MarcelMG/STM32F373_Dev_Board/README.md

# STM32F373_Dev_Board
a development board for the STM32F373 microcontroller with USB and separate analog power supply
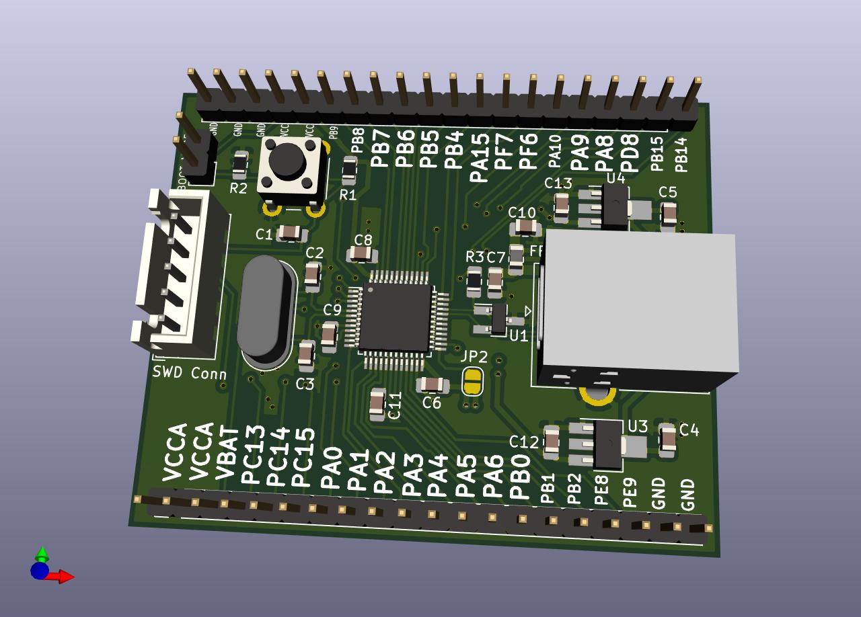
[picture p1: rendering3D.jpg]
3drendering
