MarcelMG/STM32F373_Dev_Board/BOM_parts_RSComponents.xlsx

Best.-Nr. | Bezeichnung | Stückpreis | Anzahl | Mindestbestellmenge | Preis
698-4064 | 27pF 0805 | 0.06 | 10 | 5 | 0.6
814-9412 | 8MHz Quarz | 0.172 | 10 | 10 | 1.72
751-3033 | 3.3V LDO Regler | 0.108 | 25 | 25 | 2.7
298-9309 (https://de.rs-online.com/web/p/keramik-vielschichtkondensatoren/2989309/) | 10nF 0805 | 0.004 | 25 | 25 | 0.1
264-4450 | 1µF Kondensator | 0.043 | 25 | 25 | 1.075
674-1328 | USB Buchse Typ B weibl. | 0.896 | 5 | 5 | 4.48
740-8990 (https://de.rs-online.com/web/p/smd-widerstande/7408990/) | 1.5k 0805 | 0.012 | 50 | 50 | 0.6
709-9054 | USB ESD Schutz | 0.496 | 5 | 5 | 2.48
724-1501 | Ferritperle | 0.024 | 25 | 25 | 0.6
464-6688 (https://de.rs-online.com/web/p/keramik-vielschichtkondensatoren/4646688/) | 100nF 0805 | 0.011 | 50 | 50 | 0.55
152-6094 (https://de.rs-online.com/web/p/keramik-vielschichtkondensatoren/1526094/) | 4.7µF 0805 | 0.205 | 10 | 10 | 2.05
794-4055 | Taster | 0.082 | 5 | 5 | 0.41
674-2340 | 20pin 2.54mm Stiftleiste | 0.416 | 5 | 5 | 2.08
795-9167 | Mikrocontroller STM32F373 | 5.28 | 3 | 1 | 15.84
820-1560 | JST 5pin Buchse | 0.43 | 5 | 5 | 2.15
820-1541 | Kabel mit JST Kontakt | 0.68 | 10 | 10 | 6.8
820-1627 | Stecker Gehäuse JST XH | 0.108 | 5 | 5 | 0.54
788-3972 | 10k 0805 | 0.011 | 50 | 50 | 0.55
674-2400 (https://de.rs-online.com/web/p/jumper-und-steckbrucken/6742400/) | Jumper | 0.067 | 10 | 10 | 0.67
