MarcelMG/STM32F373_Dev_Board/schematic.pdf

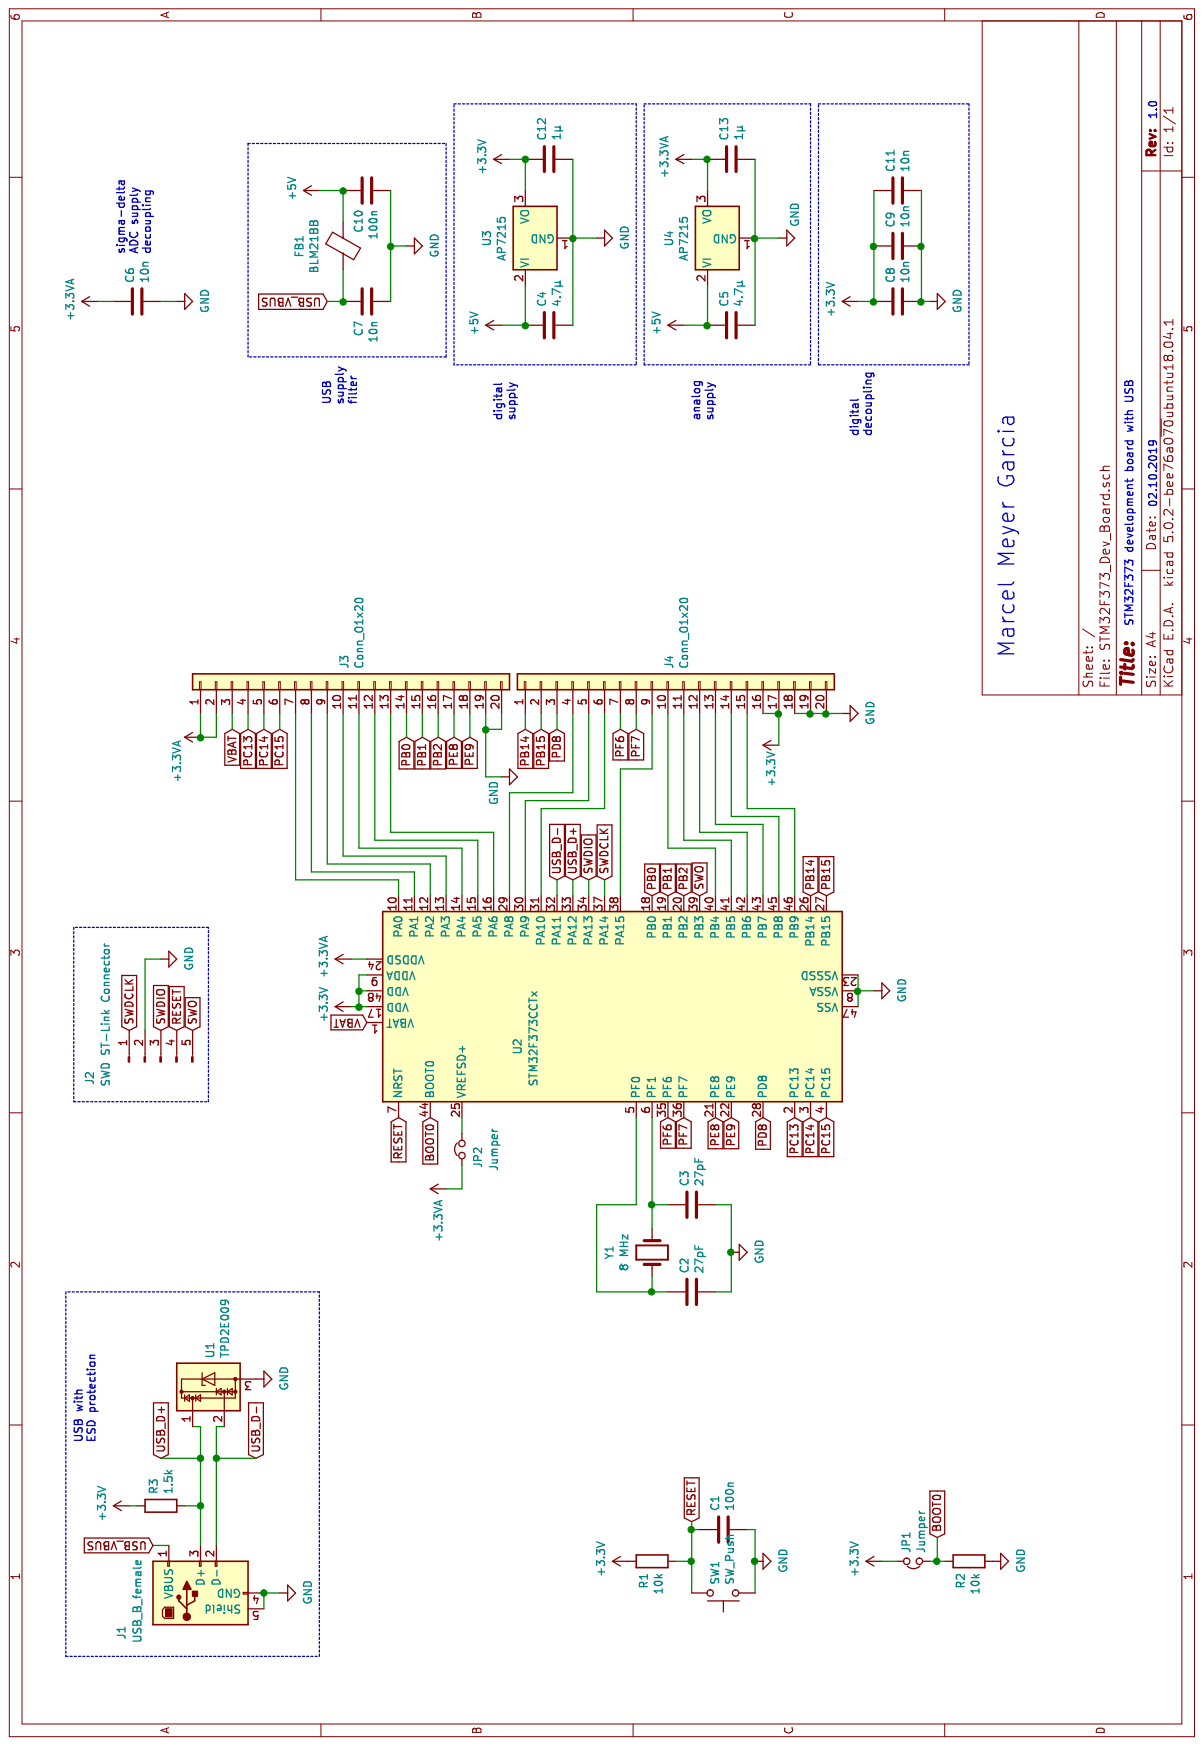
[picture p2: page 1]
