MarcelMG/STM32F373_Dev_Board/STM32F373_Dev_Board.kicad_pcb

## KiCad design STM32F373_Dev_Board.kicad_pcb (2019-10-04)

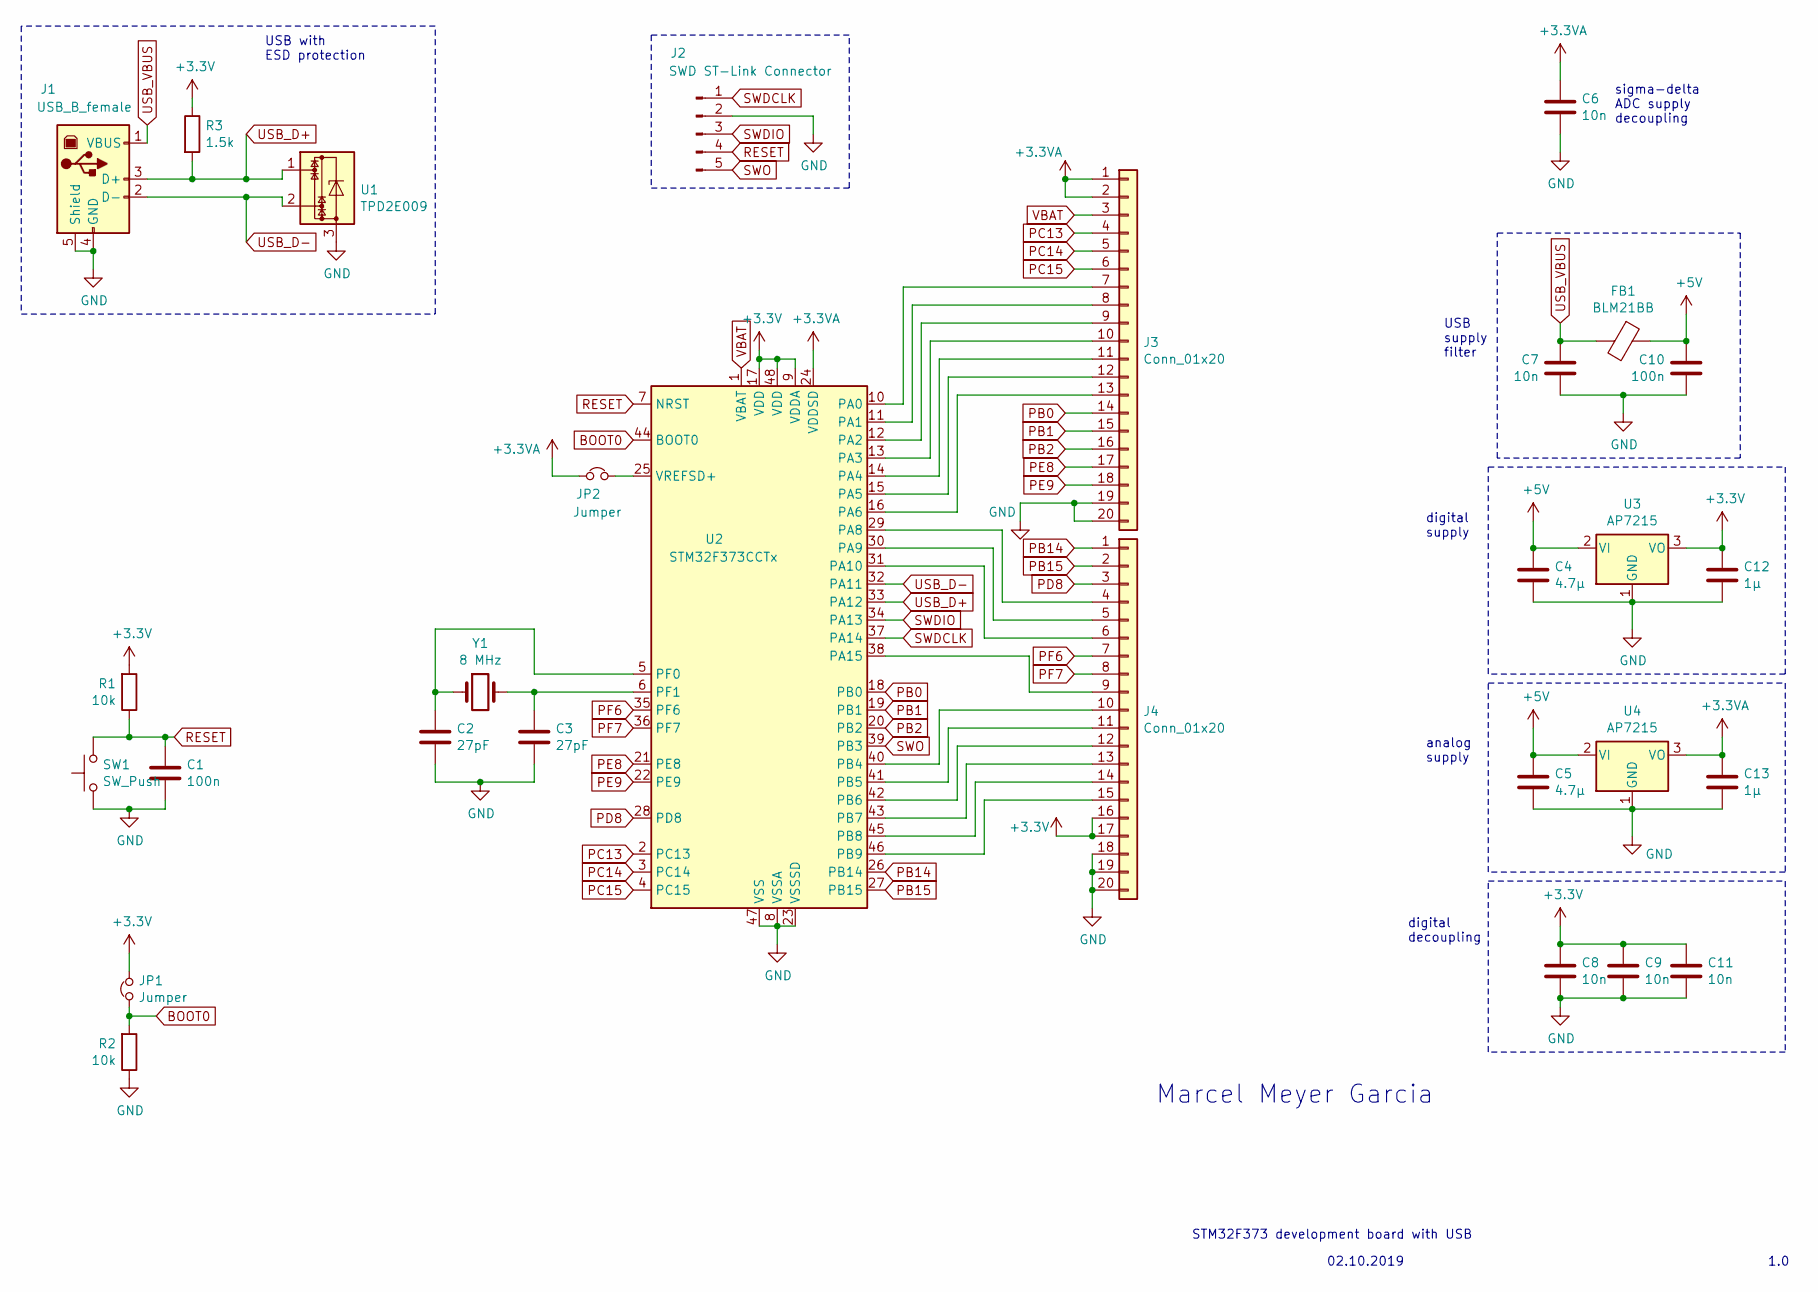
[picture p3: schematic STM32F373_Dev_Board.sch]

Parts:
C1, C10: 100n; C_0805_2012Metric_Pad1.15x1.40mm_HandSolder
C2, C3: 27pF; C_0805_2012Metric_Pad1.15x1.40mm_HandSolder
C4, C5: 4.7µ; C_0805_2012Metric_Pad1.15x1.40mm_HandSolder
C6, C7, C8, C9, C11: 10n; C_0805_2012Metric_Pad1.15x1.40mm_HandSolder
C12, C13: 1µ; C_0805_2012Metric_Pad1.15x1.40mm_HandSolder
FB1: BLM21BB; L_0805_2012Metric_Pad1.15x1.40mm_HandSolder
J1: USB_B_female; USB_B_OST_USB-B1HSxx_Horizontal
J2: SWD ST-Link Connector; JST_XH_B05B-XH-A_1x05_P2.50mm_Vertical
J3, J4: Conn_01x20; PinHeader_1x20_P2.54mm_Vertical
JP1: Jumper; PinHeader_1x02_P2.54mm_Vertical
JP2: Jumper; SolderJumper-2_P1.3mm_Open_RoundedPad1.0x1.5mm
R1, R2: 10k; R_0805_2012Metric_Pad1.15x1.40mm_HandSolder
R3: 1.5k; R_0805_2012Metric_Pad1.15x1.40mm_HandSolder
SW1: SW_Push; SW_PUSH_6mm_H5mm
U1: TPD2E009; SOT-23_Handsoldering
U2: STM32F373CCTx; LQFP-48_7x7mm_P0.5mm
U3, U4: AP7215; SOT-89-3_Handsoldering
Y1: 8 MHz; Crystal_HC49-U_Vertical

Connections:
+3.3VA: C6.1, C13.1, J3.1, J3.2, JP2.2, U2.24 (VDDSD), U4.3 (VO)
+3V3: C8.1, C9.1, C11.1, C12.1, J4.16, J4.17, JP1.1, R1.2, R3.1, U2.9 (VDDA), U2.17 (VDD), U2.48 (VDD), U3.3 (VO)
+5V: C4.1, C5.1, C10.2, FB1.1, U3.2 (VI), U4.2 (VI)
BOOT0: JP1.2, R2.2, U2.44 (BOOT0)
GND: C1.1, C2.2, C3.2, C4.2, C5.2, C6.2, C7.1, C8.2, C9.2, C10.1, C11.2, C12.2, C13.2, J1.4 (GND), J1.5 (Shield), J2.2, J3.19, J3.20, J4.18, J4.19, J4.20, R2.1, SW1.1, U1.3, U2.8 (VSSA), U2.23 (VSSSD), U2.47 (VSS), U3.1 (GND), U4.1 (GND); also elsewhere on the board
unnamed: C2.1, U2.5 (PF0), Y1.1
unnamed: C3.1, U2.6 (PF1), Y1.2
unnamed: J3.7, U2.10 (PA0)
unnamed: J3.8, U2.11 (PA1)
unnamed: J3.9, U2.12 (PA2)
unnamed: J3.10, U2.13 (PA3)
unnamed: J3.11, U2.14 (PA4)
unnamed: J3.12, U2.15 (PA5)
unnamed: J3.13, U2.16 (PA6)
unnamed: J4.4, U2.29 (PA8)
unnamed: J4.5, U2.30 (PA9)
unnamed: J4.6, U2.31 (PA10)
unnamed: J4.9, U2.38 (PA15)
unnamed: J4.10, U2.40 (PB4)
unnamed: J4.11, U2.41 (PB5)
unnamed: J4.12, U2.42 (PB6)
unnamed: J4.13, U2.43 (PB7)
unnamed: J4.14, U2.45 (PB8)
unnamed: J4.15, U2.46 (PB9)
unnamed: JP2.1, U2.25 (VREFSD+)
PB0: J3.14, U2.18 (PB0)
PB1: J3.15, U2.19 (PB1)
PB2: J3.16, U2.20 (PB2)
PB14: J4.1, U2.26 (PB14)
PB15: J4.2, U2.27 (PB15)
PC13: J3.4, U2.2 (PC13)
PC14: J3.5, U2.3 (PC14)
PC15: J3.6, U2.4 (PC15)
PD8: J4.3, U2.28 (PD8)
PE8: J3.17, U2.21 (PE8)
PE9: J3.18, U2.22 (PE9)
PF6: J4.7, U2.35 (PF6)
PF7: J4.8, U2.36 (PF7)
RESET: C1.2, J2.4, R1.1, SW1.2, U2.7 (NRST); also elsewhere on the board
SWDCLK: J2.1, U2.37 (PA14); also elsewhere on the board
SWDIO: J2.3, U2.34 (PA13); also elsewhere on the board
SWO: J2.5, U2.39 (PB3); also elsewhere on the board
USB_D+: J1.3 (D+), R3.2, U1.1, U2.33 (PA12)
USB_D-: J1.2 (D-), U1.2, U2.32 (PA11)
USB_VBUS: C7.2, FB1.2, J1.1 (VBUS)
VBAT: J3.3, U2.1 (VBAT)

Notes on the sheet:
digital supply
USB supply filter
analog supply
digital decoupling
sigma-delta ADC supply decoupling
USB with ESD protection
STM32F373 development board with USB
02.10.2019
1.0
Marcel Meyer Garcia

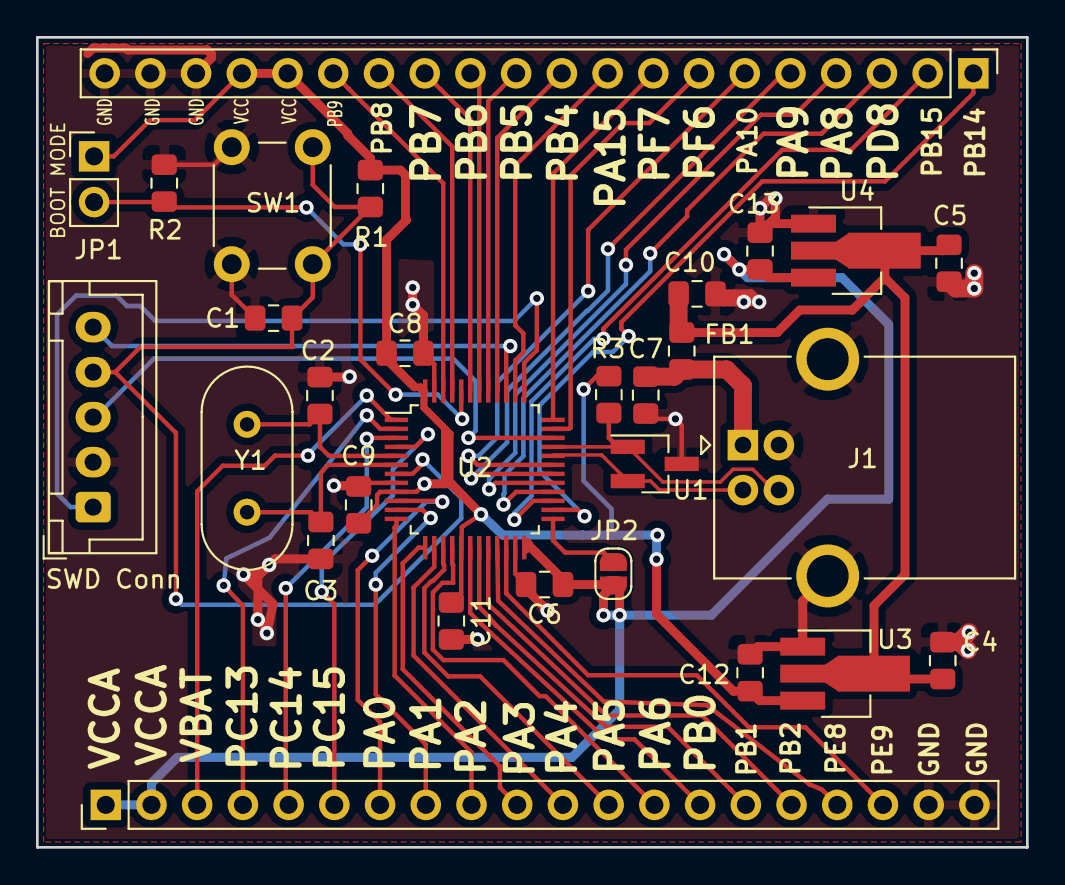
[picture p4: board STM32F373_Dev_Board.kicad_pcb from above]

Board: 2 copper layers, 55.0 x 45.0 mm, 29 parts (0 on the bottom side), 46 nets.

Other parts of the board:
SWD Conn: SWD ST-Link Connector; JST_XH_B05B-XH-A_1x05_P2.50mm_Vertical

Their connections:
GND: SWD Conn.2; also elsewhere on the board
RESET: SWD Conn.4; also elsewhere on the board
SWDCLK: SWD Conn.1; also elsewhere on the board
SWDIO: SWD Conn.3; also elsewhere on the board
SWO: SWD Conn.5; also elsewhere on the board
