MarcelMG/STM32F373_Dev_Board/(commit log)

2020-01-27 removed unnecessary files
    [STM32F373_Dev_Board-B.Cu.gbl, STM32F373_Dev_Board-B.Mask.gbs, STM32F373_Dev_Board-B.Paste.gbp, STM32F373_Dev_Board-B.SilkS.gbo, STM32F373_Dev_Board-Edge.Cuts.gm1, STM32F373_Dev_Board-F.Cu.gtl, STM32F373_Dev_Board-F.Mask.gts, STM32F373_Dev_Board-F.Paste.gtp]
2020-01-27 renamed file to specify distributor
    [BOM_parts_RSComponents.xlsx]
