MarcelMG/STM32F373_Dev_Board/(notices)

Notices in the files:
STM32F373_Dev_Board.kicad_pcb:
(c) 2019 by MarcelMG
